3nicholas03/GTSR-POCAN/ADC.kicad_sch

## KiCad design ADC.kicad_sch (2026-01-30)

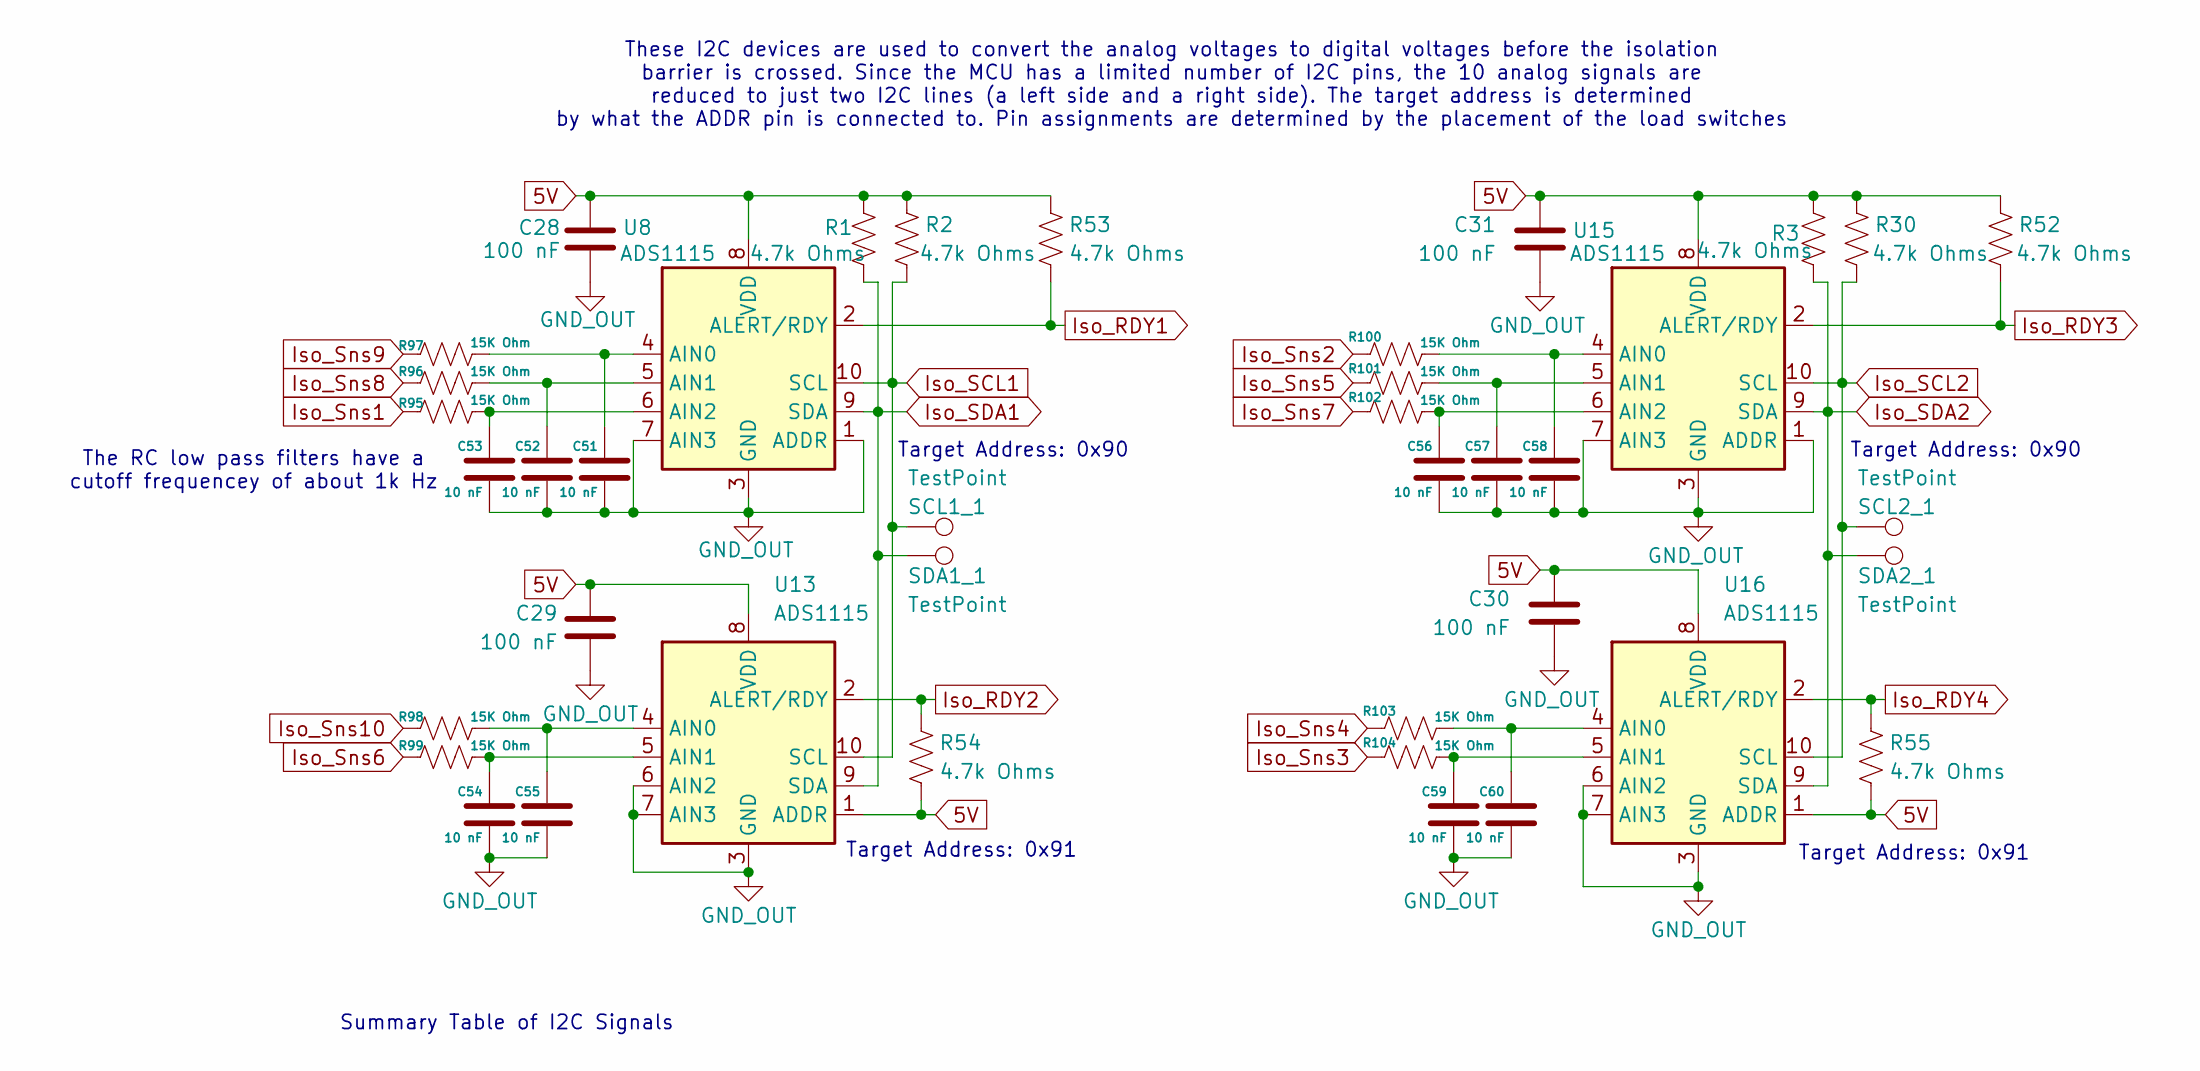
[picture p1: schematic ADC.kicad_sch]

Parts:
C28, C29, C30, C31: 100 nF; C_0603_1608Metric
C51, C52, C53, C54, C55, C56, C57, C58, C59, C60: 10 nF; C_0603_1608Metric
R1, R2, R3, R30, R52, R53, R54, R55: 4.7k Ohms; R_0603_1608Metric
R95, R96, R97, R98, R99, R100, R101, R102, R103, R104: 15K Ohm; R_0603_1608Metric
SCL1_1, SCL2_1: TestPoint; TestPoint_Keystone_5000-5004_Miniature
SDA1_1, SDA2_1: TestPoint; TestPoint_Keystone_5000-5004_Miniature
U8, U13, U15, U16: ADS1115; VSSOP-10_3x3mm_P0.5mm

Connections:
5V: C28.1, C29.1, C30.1, C31.1, R1.1, R2.1, R3.1, R30.1, R52.1, R53.1, R54.2, R55.2, U8.8 (VDD), U13.1 (ADDR), U13.8 (VDD), U15.8 (VDD), U16.1 (ADDR), U16.8 (VDD)
GND_OUT: C28.2, C29.2, C30.2, C31.2, C51.2, C52.2, C53.2, C54.2, C55.2, C56.2, C57.2, C58.2, C59.2, C60.2, U8.1 (ADDR), U8.3 (GND), U8.7 (AIN3), U13.3 (GND), U13.6 (AIN2), U13.7 (AIN3), U15.1 (ADDR), U15.3 (GND), U15.7 (AIN3), U16.3 (GND), U16.6 (AIN2), U16.7 (AIN3)
Iso_RDY1: R53.2, U8.2 (ALERT/RDY)
Iso_RDY2: R54.1, U13.2 (ALERT/RDY)
Iso_RDY3: R52.2, U15.2 (ALERT/RDY)
Iso_RDY4: R55.1, U16.2 (ALERT/RDY)
Iso_SCL1: R2.2, SCL1_1.1, U8.10 (SCL), U13.10 (SCL)
Iso_SCL2: R30.2, SCL2_1.1, U15.10 (SCL), U16.10 (SCL)
Iso_SDA1: R1.2, SDA1_1.1, U8.9 (SDA), U13.9 (SDA)
Iso_SDA2: R3.2, SDA2_1.1, U15.9 (SDA), U16.9 (SDA)
Iso_Sns1: R95.2
Iso_Sns2: R100.2
Iso_Sns3: R104.2
Iso_Sns4: R103.2
Iso_Sns5: R101.2
Iso_Sns6: R99.2
Iso_Sns7: R102.2
Iso_Sns8: R96.2
Iso_Sns9: R97.2
Iso_Sns10: R98.2
unnamed: C51.1, R97.1, U8.4 (AIN0)
unnamed: C52.1, R96.1, U8.5 (AIN1)
unnamed: C53.1, R95.1, U8.6 (AIN2)
unnamed: C54.1, R99.1, U13.5 (AIN1)
unnamed: C55.1, R98.1, U13.4 (AIN0)
unnamed: C56.1, R102.1, U15.6 (AIN2)
unnamed: C57.1, R101.1, U15.5 (AIN1)
unnamed: C58.1, R100.1, U15.4 (AIN0)
unnamed: C59.1, R104.1, U16.5 (AIN1)
unnamed: C60.1, R103.1, U16.4 (AIN0)

Notes on the sheet:
Target Address: 0x91
These I2C devices are used to convert the analog voltages to digital voltages before the isolation barrier is crossed. Since the MCU has a limited number of I2C pins, the 10 analog signals are reduced to just two I2C lines (a left side and a right side). The target address is determined by what the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
Target Address: 0x90
Summary Table of I2C Signals
The RC low pass filters have a cutoff frequencey of about 1k Hz
