3nicholas03/GTSR-POCAN/CAN.kicad_sch

## KiCad design CAN.kicad_sch (2026-01-30)

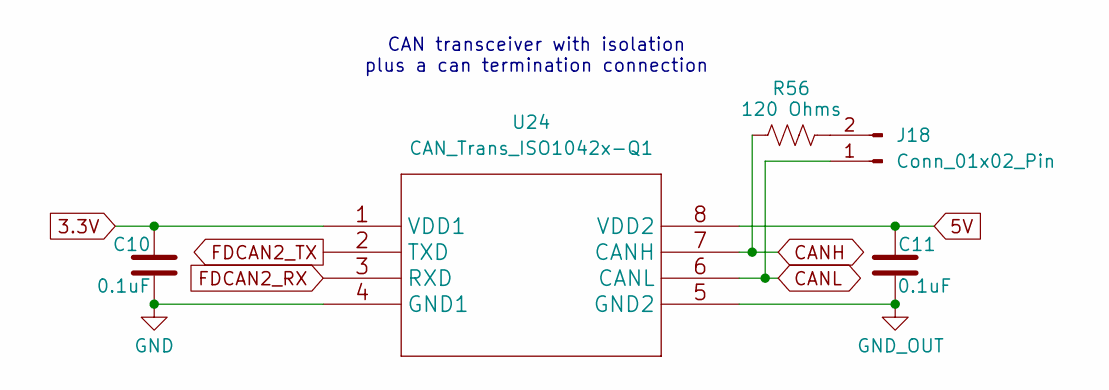
[picture p2: schematic CAN.kicad_sch]

Parts:
C10, C11: 0.1uF; C_0603_1608Metric
J18: Conn_01x02_Pin; PinHeader_1x02_P2.54mm_Vertical
R56: 120 Ohms; R_0603_1608Metric; Part Name R_0603_120
U24: CAN_Trans_ISO1042x-Q1; SOIC-8_7.5x5.85mm_P1.27mm

Connections:
3.3V: C10.2, U24.1 (VDD1)
5V: C11.2, U24.8 (VDD2)
CANH: R56.2, U24.7 (CANH)
CANL: J18.1, U24.6 (CANL)
FDCAN2_RX: U24.3 (RXD)
FDCAN2_TX: U24.2 (TXD)
GND: C10.1, U24.4 (GND1)
GND_OUT: C11.1, U24.5 (GND2)
unnamed: J18.2, R56.1

Notes on the sheet:
CAN transceiver with isolation plus a can termination connection
