3nicholas03/GTSR-POCAN/Digital_Isolation.kicad_sch

## KiCad design Digital_Isolation.kicad_sch (2026-01-30)

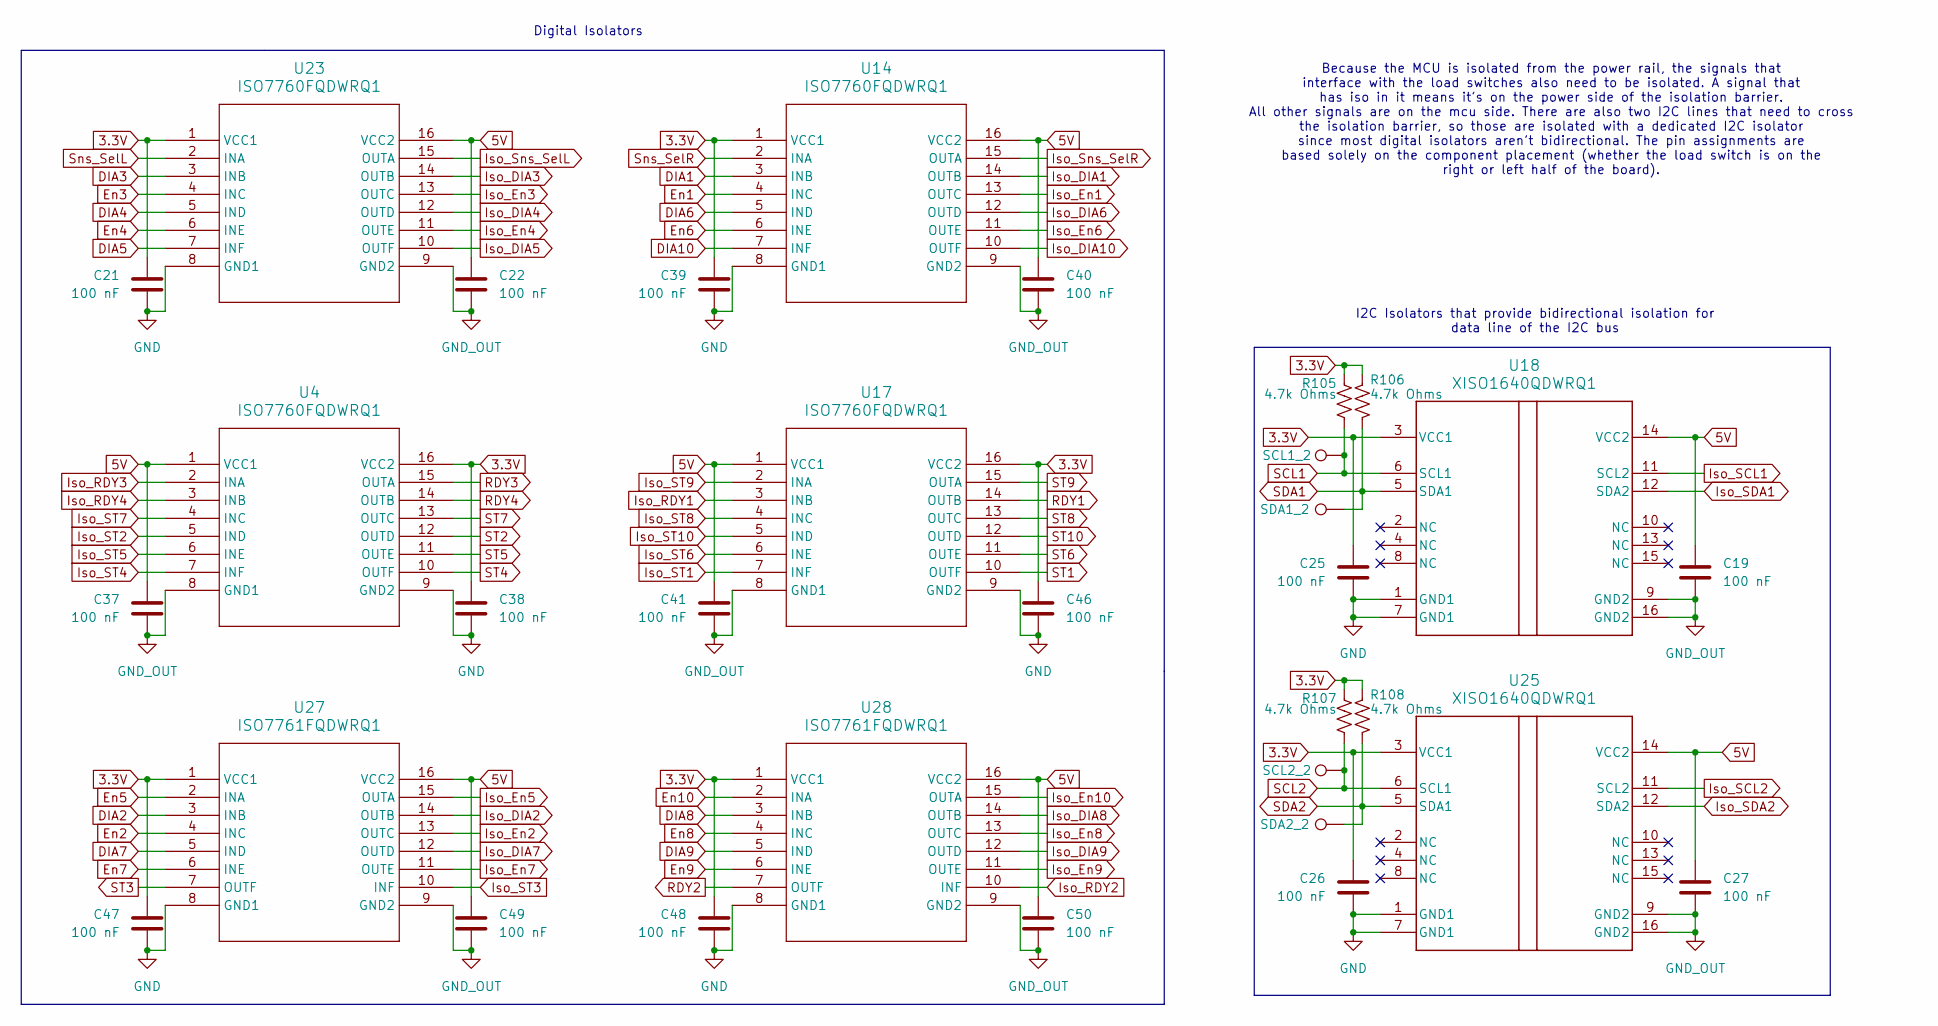
[picture p3: schematic Digital_Isolation.kicad_sch]

Parts:
C19, C21, C22, C25, C26, C27, C37, C38, C39, C40, C41, C46, C47, C48, C49, C50: 100 nF; C_0603_1608Metric
R105, R106, R107, R108: 4.7k Ohms; R_0603_1608Metric
SCL1_2, SCL2_2: TestPoint; TestPoint_Keystone_5000-5004_Miniature
SDA1_2, SDA2_2: TestPoint; TestPoint_Keystone_5000-5004_Miniature
U4, U14, U17, U23: ISO7760FQDWRQ1; SOIC-16W_7.5x10.3mm_P1.27mm
U18, U25: XISO1640QDWRQ1; SOIC-16W_7.5x10.3mm_P1.27mm
U27, U28: ISO7761FQDWRQ1; SOIC-16W_7.5x10.3mm_P1.27mm

Connections:
3.3V: C21.1, C25.1, C26.1, C38.1, C39.1, C46.1, C47.1, C48.1, R105.1, R106.1, R107.1, R108.1, U4.16 (VCC2), U14.1 (VCC1), U17.16 (VCC2), U18.3 (VCC1), U23.1 (VCC1), U25.3 (VCC1), U27.1 (VCC1), U28.1 (VCC1)
5V: C19.1, C22.1, C27.1, C37.1, C40.1, C41.1, C49.1, C50.1, U4.1 (VCC1), U14.16 (VCC2), U17.1 (VCC1), U18.14 (VCC2), U23.16 (VCC2), U25.14 (VCC2), U27.16 (VCC2), U28.16 (VCC2)
DIA1: U14.3 (INB)
DIA2: U27.3 (INB)
DIA3: U23.3 (INB)
DIA4: U23.5 (IND)
DIA5: U23.7 (INF)
DIA6: U14.5 (IND)
DIA7: U27.5 (IND)
DIA8: U28.3 (INB)
DIA9: U28.5 (IND)
DIA10: U14.7 (INF)
En1: U14.4 (INC)
En2: U27.4 (INC)
En3: U23.4 (INC)
En4: U23.6 (INE)
En5: U27.2 (INA)
En6: U14.6 (INE)
En7: U27.6 (INE)
En8: U28.4 (INC)
En9: U28.6 (INE)
En10: U28.2 (INA)
GND: C21.2, C25.2, C26.2, C38.2, C39.2, C46.2, C47.2, C48.2, U4.9 (GND2), U14.8 (GND1), U17.9 (GND2), U18.1 (GND1), U18.7 (GND1), U23.8 (GND1), U25.1 (GND1), U25.7 (GND1), U27.8 (GND1), U28.8 (GND1)
GND_OUT: C19.2, C22.2, C27.2, C37.2, C40.2, C41.2, C49.2, C50.2, U4.8 (GND1), U14.9 (GND2), U17.8 (GND1), U18.9 (GND2), U18.16 (GND2), U23.9 (GND2), U25.9 (GND2), U25.16 (GND2), U27.9 (GND2), U28.9 (GND2)
Iso_DIA1: U14.14 (OUTB)
Iso_DIA2: U27.14 (OUTB)
Iso_DIA3: U23.14 (OUTB)
Iso_DIA4: U23.12 (OUTD)
Iso_DIA5: U23.10 (OUTF)
Iso_DIA6: U14.12 (OUTD)
Iso_DIA7: U27.12 (OUTD)
Iso_DIA8: U28.14 (OUTB)
Iso_DIA9: U28.12 (OUTD)
Iso_DIA10: U14.10 (OUTF)
Iso_En1: U14.13 (OUTC)
Iso_En2: U27.13 (OUTC)
Iso_En3: U23.13 (OUTC)
Iso_En4: U23.11 (OUTE)
Iso_En5: U27.15 (OUTA)
Iso_En6: U14.11 (OUTE)
Iso_En7: U27.11 (OUTE)
Iso_En8: U28.13 (OUTC)
Iso_En9: U28.11 (OUTE)
Iso_En10: U28.15 (OUTA)
Iso_RDY1: U17.3 (INB)
Iso_RDY2: U28.10 (INF)
Iso_RDY3: U4.2 (INA)
Iso_RDY4: U4.3 (INB)
Iso_SCL1: U18.11 (SCL2)
Iso_SCL2: U25.11 (SCL2)
Iso_SDA1: U18.12 (SDA2)
Iso_SDA2: U25.12 (SDA2)
Iso_ST1: U17.7 (INF)
Iso_ST2: U4.5 (IND)
Iso_ST3: U27.10 (INF)
Iso_ST4: U4.7 (INF)
Iso_ST5: U4.6 (INE)
Iso_ST6: U17.6 (INE)
Iso_ST7: U4.4 (INC)
Iso_ST8: U17.4 (INC)
Iso_ST9: U17.2 (INA)
Iso_ST10: U17.5 (IND)
Iso_Sns_SelL: U23.15 (OUTA)
Iso_Sns_SelR: U14.15 (OUTA)
RDY1: U17.14 (OUTB)
RDY2: U28.7 (OUTF)
RDY3: U4.15 (OUTA)
RDY4: U4.14 (OUTB)
SCL1: R105.2, SCL1_2.1, U18.6 (SCL1)
SCL2: R107.2, SCL2_2.1, U25.6 (SCL1)
SDA1: R106.2, SDA1_2.1, U18.5 (SDA1)
SDA2: R108.2, SDA2_2.1, U25.5 (SDA1)
ST1: U17.10 (OUTF)
ST2: U4.12 (OUTD)
ST3: U27.7 (OUTF)
ST4: U4.10 (OUTF)
ST5: U4.11 (OUTE)
ST6: U17.11 (OUTE)
ST7: U4.13 (OUTC)
ST8: U17.13 (OUTC)
ST9: U17.15 (OUTA)
ST10: U17.12 (OUTD)
Sns_SelL: U23.2 (INA)
Sns_SelR: U14.2 (INA)

Notes on the sheet:
I2C Isolators that provide bidirectional isolation for data line of the I2C bus
Digital Isolators
Because the MCU is isolated from the power rail, the signals that interface with the load switches also need to be isolated. A signal that has iso in it means it's on the power side of the isolation barrier. All other signals are on the mcu side. There are also two I2C lines that need to cross the 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
