3nicholas03/GTSR-POCAN/Inputs.kicad_sch

## KiCad design Inputs.kicad_sch (2026-01-30)

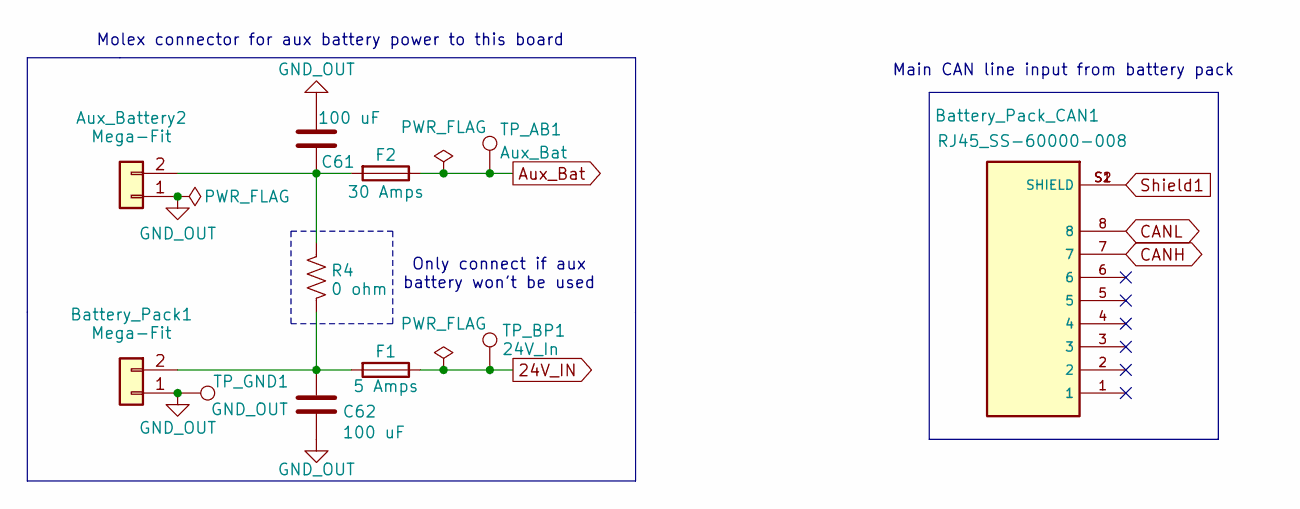
[picture p4: schematic Inputs.kicad_sch]

Parts:
Aux_Battery2: Mega-Fit; Molex_Mega-Fit_76829-0002_2x01_P5.70mm_Vertical; PARTREV A
Battery_Pack1: Mega-Fit; Molex_Mega-Fit_76829-0002_2x01_P5.70mm_Vertical; PARTREV A
Battery_Pack_CAN1: RJ45_SS-60000-008; ASSMANN_A-2004-2-4-LPS-N-R
C61, C62: 100 uF; CP_Elec_10x10
F1: 5 Amps; FUSE_3581
F2: 30 Amps; FUSE_3581
R4: 0 ohm; R_Axial_DIN0207_L6.3mm_D2.5mm_P7.62mm_Horizontal
TP_AB1: Aux_Bat; TestPoint_Pad_D1.5mm
TP_BP1: 24V_In; TestPoint_Pad_D1.5mm
TP_GND1: GND_OUT; TestPoint_Pad_D1.5mm

Connections:
24V_IN: F1.1, TP_BP1.1
Aux_Bat: F2.1, TP_AB1.1
CANH: Battery_Pack_CAN1.7
CANL: Battery_Pack_CAN1.8
GND_OUT: Aux_Battery2.1, Battery_Pack1.1, C61.2, C62.2, TP_GND1.1
unnamed: Aux_Battery2.2, C61.1, F2.2, R4.2
unnamed: Battery_Pack1.2, C62.1, F1.2, R4.1
Shield1: Battery_Pack_CAN1.S1 (SHIELD), Battery_Pack_CAN1.S2 (SHIELD)

Notes on the sheet:
Only connect if aux battery won't be used
Molex connector for aux battery power to this board
Main CAN line input from battery pack
