3nicholas03/GTSR-POCAN/Load_Switches.kicad_sch

## KiCad design Load_Switches.kicad_sch (2026-01-30)

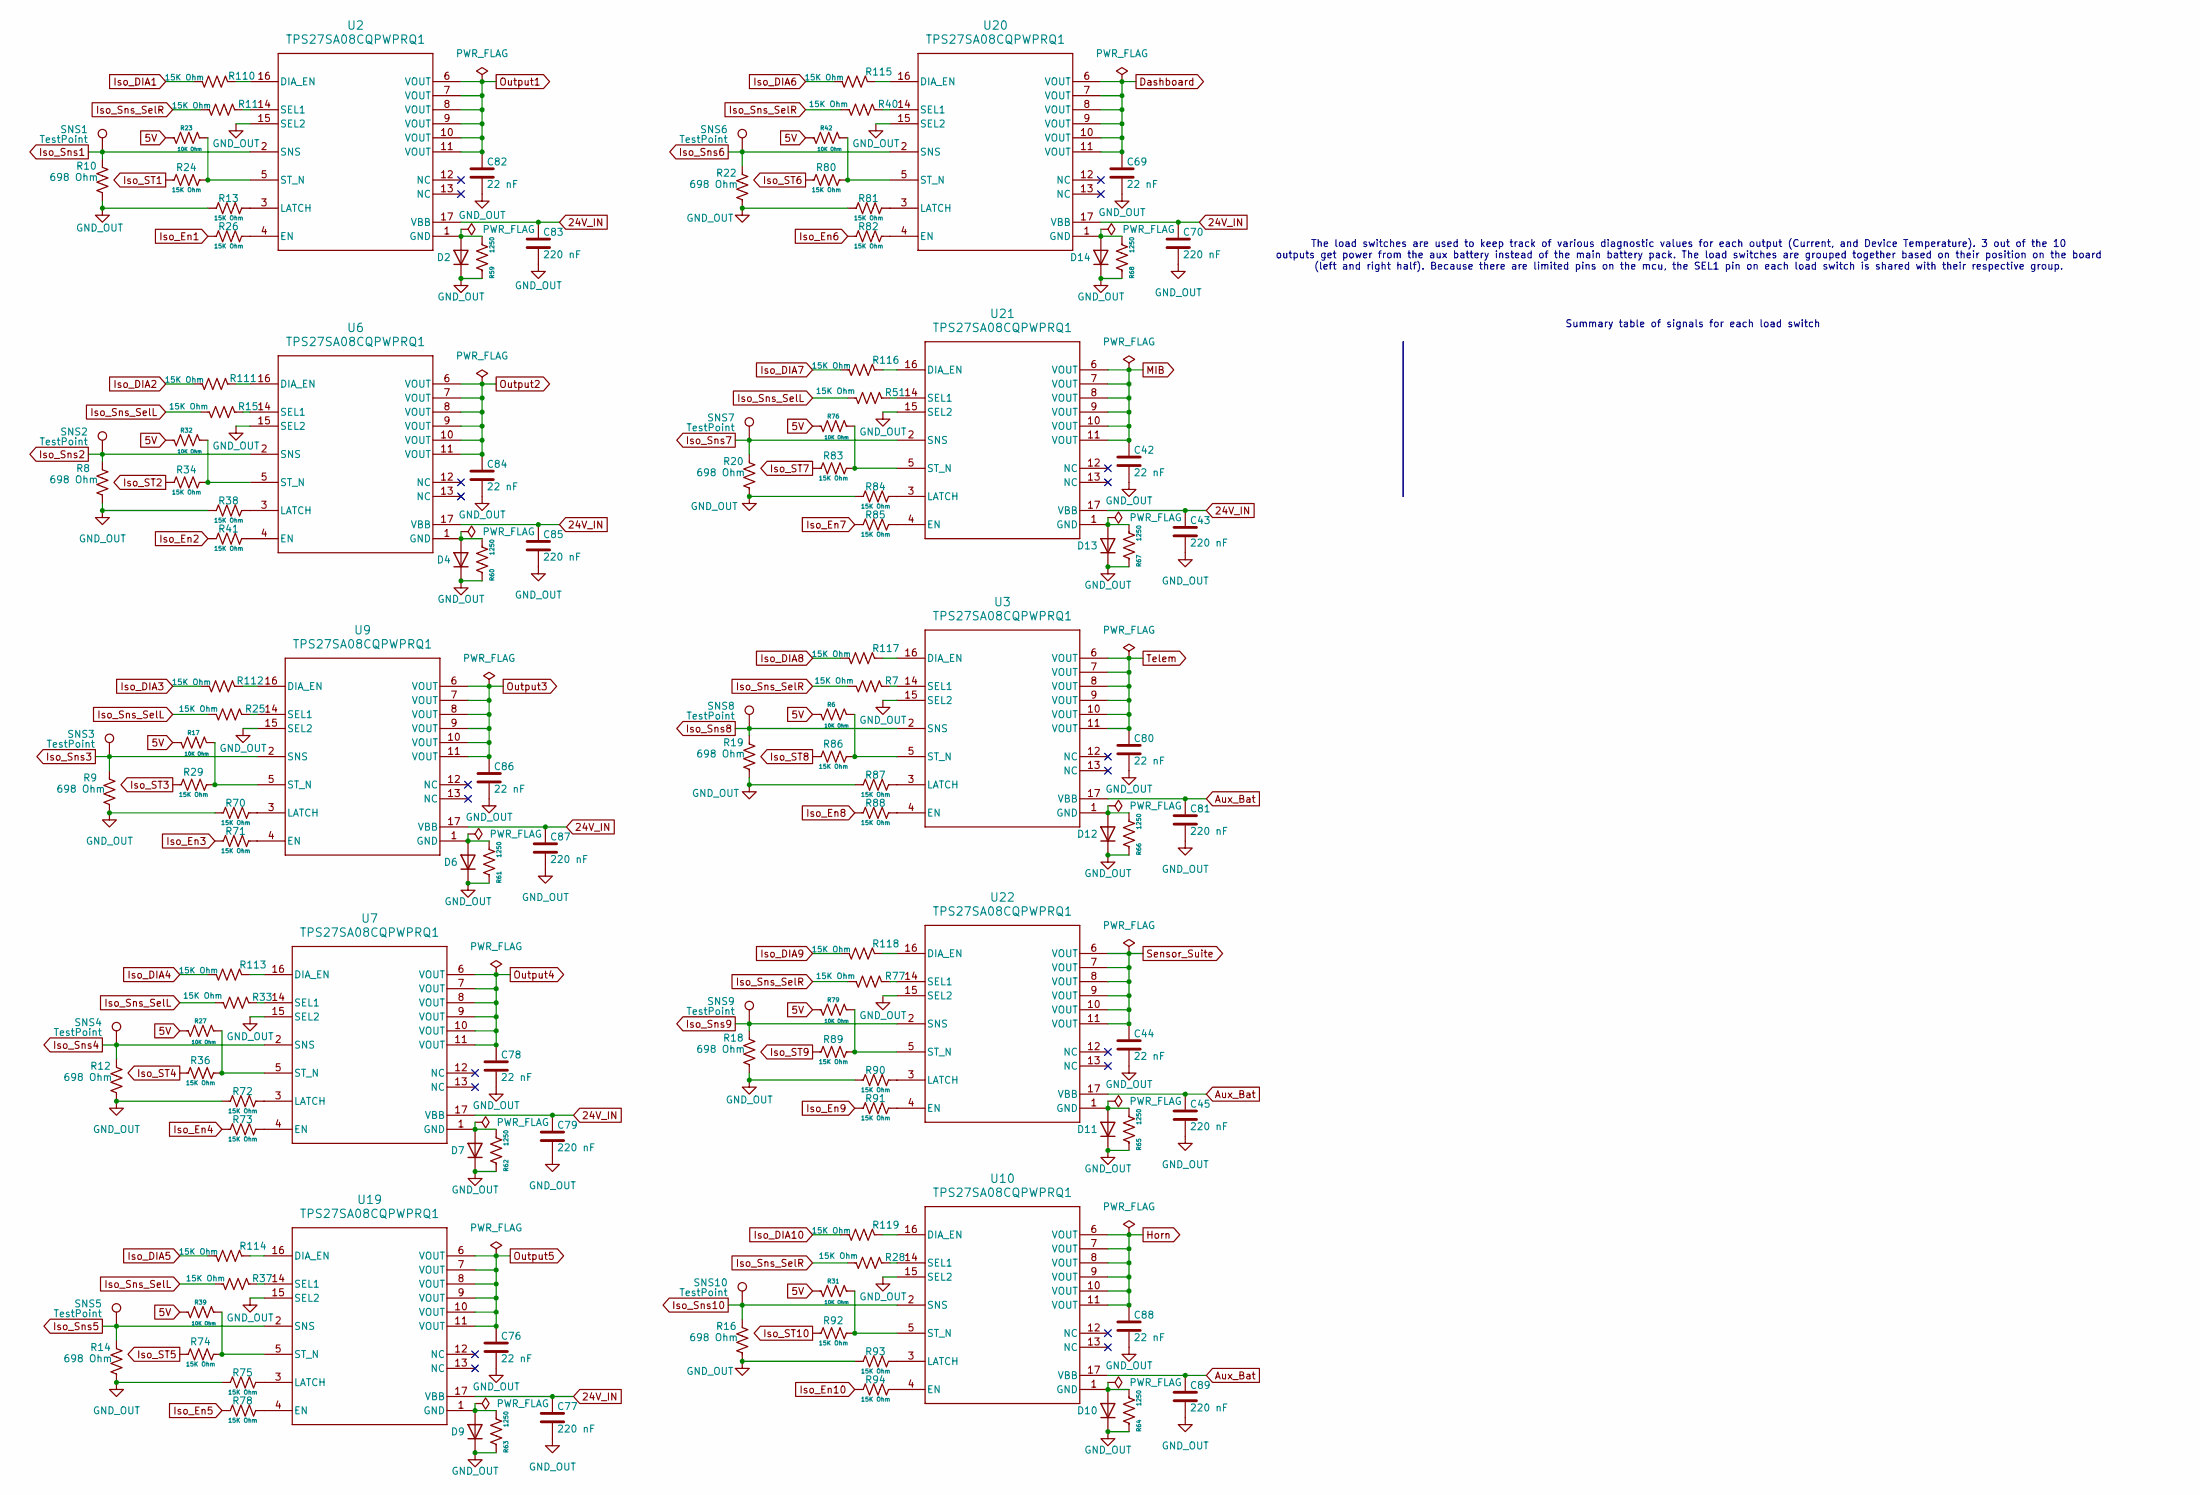
[picture p5: schematic Load_Switches.kicad_sch]

Parts:
C42, C44, C69, C76, C78, C80, C82, C84, C86, C88: 22 nF; C_0603_1608Metric
C43, C45, C70, C77, C79, C81, C83, C85, C87, C89: 220 nF; C_0603_1608Metric
D2, D4, D6, D7, D9, D10, D11, D12, D13, D14: BAS21; SOT-23
R6, R17, R23, R27, R31, R32, R39, R42, R76, R79: 10K Ohm; R_0603_1608Metric
R7, R11, R13, R15, R24, R25, R26, R28, R29, R33, R34, R36, R37, R38, R40, R41, R51, R70, R71, R72, R73, R74, R75, R77, R78, R80, R81, R82, R83, R84, R85, R86, R87, R88, R89, R90, R91, R92, R93, R94, R110, R111, R112, R113, R114, R115, R116, R117, R118, R119: 15K Ohm; R_0603_1608Metric
R8, R9, R10, R12, R14, R16, R18, R19, R20, R22: 698 Ohm; R_0603_1608Metric
R59, R60, R61, R62, R63, R64, R65, R66, R67, R68: 1250; R_0603_1608Metric
SNS1, SNS2, SNS3, SNS4, SNS5, SNS6, SNS7, SNS8, SNS9, SNS10: TestPoint; TestPoint_Keystone_5000-5004_Miniature
U2, U3, U6, U7, U9, U10, U19, U20, U21, U22: TPS27SA08CQPWPRQ1; HTSSOP-16-1EP_4.4x5mm_P0.65mm_EP3.4x5mm

Connections:
5V: R6.2, R17.2, R23.2, R27.2, R31.2, R32.2, R39.2, R42.2, R76.2, R79.2
24V_IN: C43.1, C70.1, C77.1, C79.1, C83.1, C85.1, C87.1, U2.17 (VBB), U6.17 (VBB), U7.17 (VBB), U9.17 (VBB), U19.17 (VBB), U20.17 (VBB), U21.17 (VBB)
Aux_Bat: C45.1, C81.1, C89.1, U3.17 (VBB), U10.17 (VBB), U22.17 (VBB)
Dashboard: C69.1, U20.6 (VOUT), U20.7 (VOUT), U20.8 (VOUT), U20.9 (VOUT), U20.10 (VOUT), U20.11 (VOUT)
GND_OUT: C42.2, C43.2, C44.2, C45.2, C69.2, C70.2, C76.2, C77.2, C78.2, C79.2, C80.2, C81.2, C82.2, C83.2, C84.2, C85.2, C86.2, C87.2, C88.2, C89.2, D2.3 (K), D4.3 (K), D6.3 (K), D7.3 (K), D9.3 (K), D10.3 (K), D11.3 (K), D12.3 (K), D13.3 (K), D14.3 (K), R8.2, R9.2, R10.2, R12.2, R13.2, R14.2, R16.2, R18.2, R19.2, R20.2, R22.2, R38.2, R59.1, R60.1, R61.1, R62.1, R63.1, R64.1, R65.1, R66.1, R67.1, R68.1, R70.2, R72.2, R75.2, R81.2, R84.2, R87.2, R90.2, R93.2, U2.15 (SEL2), U3.15 (SEL2), U6.15 (SEL2), U7.15 (SEL2), U9.15 (SEL2), U10.15 (SEL2), U19.15 (SEL2), U20.15 (SEL2), U21.15 (SEL2), U22.15 (SEL2)
Horn: C88.1, U10.6 (VOUT), U10.7 (VOUT), U10.8 (VOUT), U10.9 (VOUT), U10.10 (VOUT), U10.11 (VOUT)
Iso_DIA1: R110.2
Iso_DIA2: R111.2
Iso_DIA3: R112.2
Iso_DIA4: R113.2
Iso_DIA5: R114.2
Iso_DIA6: R115.2
Iso_DIA7: R116.2
Iso_DIA8: R117.2
Iso_DIA9: R118.2
Iso_DIA10: R119.2
Iso_En1: R26.2
Iso_En2: R41.2
Iso_En3: R71.2
Iso_En4: R73.2
Iso_En5: R78.2
Iso_En6: R82.2
Iso_En7: R85.2
Iso_En8: R88.2
Iso_En9: R91.2
Iso_En10: R94.2
Iso_ST1: R24.2
Iso_ST2: R34.2
Iso_ST3: R29.2
Iso_ST4: R36.2
Iso_ST5: R74.2
Iso_ST6: R80.2
Iso_ST7: R83.2
Iso_ST8: R86.2
Iso_ST9: R89.2
Iso_ST10: R92.2
Iso_Sns1: R10.1, SNS1.1, U2.2 (SNS)
Iso_Sns2: R8.1, SNS2.1, U6.2 (SNS)
Iso_Sns3: R9.1, SNS3.1, U9.2 (SNS)
Iso_Sns4: R12.1, SNS4.1, U7.2 (SNS)
Iso_Sns5: R14.1, SNS5.1, U19.2 (SNS)
Iso_Sns6: R22.1, SNS6.1, U20.2 (SNS)
Iso_Sns7: R20.1, SNS7.1, U21.2 (SNS)
Iso_Sns8: R19.1, SNS8.1, U3.2 (SNS)
Iso_Sns9: R18.1, SNS9.1, U22.2 (SNS)
Iso_Sns10: R16.1, SNS10.1, U10.2 (SNS)
Iso_Sns_SelL: R15.2, R25.2, R33.2, R37.2, R51.2
Iso_Sns_SelR: R7.2, R11.2, R28.2, R40.2, R77.2
MIB: C42.1, U21.6 (VOUT), U21.7 (VOUT), U21.8 (VOUT), U21.9 (VOUT), U21.10 (VOUT), U21.11 (VOUT)
unnamed: D2.1 (A), R59.2, U2.1 (GND)
unnamed: D4.1 (A), R60.2, U6.1 (GND)
unnamed: D6.1 (A), R61.2, U9.1 (GND)
unnamed: D7.1 (A), R62.2, U7.1 (GND)
unnamed: D9.1 (A), R63.2, U19.1 (GND)
unnamed: D10.1 (A), R64.2, U10.1 (GND)
unnamed: D11.1 (A), R65.2, U22.1 (GND)
unnamed: D12.1 (A), R66.2, U3.1 (GND)
unnamed: D13.1 (A), R67.2, U21.1 (GND)
unnamed: D14.1 (A), R68.2, U20.1 (GND)
unnamed: R6.1, R86.1, U3.5 (ST_N)
unnamed: R7.1, U3.14 (SEL1)
unnamed: R11.1, U2.14 (SEL1)
unnamed: R13.1, U2.3 (LATCH)
unnamed: R15.1, U6.14 (SEL1)
unnamed: R17.1, R29.1, U9.5 (ST_N)
unnamed: R23.1, R24.1, U2.5 (ST_N)
unnamed: R25.1, U9.14 (SEL1)
unnamed: R26.1, U2.4 (EN)
unnamed: R27.1, R36.1, U7.5 (ST_N)
unnamed: R28.1, U10.14 (SEL1)
unnamed: R31.1, R92.1, U10.5 (ST_N)
unnamed: R32.1, R34.1, U6.5 (ST_N)
unnamed: R33.1, U7.14 (SEL1)
unnamed: R37.1, U19.14 (SEL1)
unnamed: R38.1, U6.3 (LATCH)
unnamed: R39.1, R74.1, U19.5 (ST_N)
unnamed: R40.1, U20.14 (SEL1)
unnamed: R41.1, U6.4 (EN)
unnamed: R42.1, R80.1, U20.5 (ST_N)
unnamed: R51.1, U21.14 (SEL1)
unnamed: R70.1, U9.3 (LATCH)
unnamed: R71.1, U9.4 (EN)
unnamed: R72.1, U7.3 (LATCH)
unnamed: R73.1, U7.4 (EN)
unnamed: R75.1, U19.3 (LATCH)
unnamed: R76.1, R83.1, U21.5 (ST_N)
unnamed: R77.1, U22.14 (SEL1)
unnamed: R78.1, U19.4 (EN)
unnamed: R79.1, R89.1, U22.5 (ST_N)
unnamed: R81.1, U20.3 (LATCH)
unnamed: R82.1, U20.4 (EN)
unnamed: R84.1, U21.3 (LATCH)
unnamed: R85.1, U21.4 (EN)
unnamed: R87.1, U3.3 (LATCH)
unnamed: R88.1, U3.4 (EN)
unnamed: R90.1, U22.3 (LATCH)
unnamed: R91.1, U22.4 (EN)
unnamed: R93.1, U10.3 (LATCH)
unnamed: R94.1, U10.4 (EN)
unnamed: R110.1, U2.16 (DIA_EN)
unnamed: R111.1, U6.16 (DIA_EN)
unnamed: R112.1, U9.16 (DIA_EN)
unnamed: R113.1, U7.16 (DIA_EN)
unnamed: R114.1, U19.16 (DIA_EN)
unnamed: R115.1, U20.16 (DIA_EN)
unnamed: R116.1, U21.16 (DIA_EN)
unnamed: R117.1, U3.16 (DIA_EN)
unnamed: R118.1, U22.16 (DIA_EN)
unnamed: R119.1, U10.16 (DIA_EN)
Output1: C82.1, U2.6 (VOUT), U2.7 (VOUT), U2.8 (VOUT), U2.9 (VOUT), U2.10 (VOUT), U2.11 (VOUT)
Output2: C84.1, U6.6 (VOUT), U6.7 (VOUT), U6.8 (VOUT), U6.9 (VOUT), U6.10 (VOUT), U6.11 (VOUT)
Output3: C86.1, U9.6 (VOUT), U9.7 (VOUT), U9.8 (VOUT), U9.9 (VOUT), U9.10 (VOUT), U9.11 (VOUT)
Output4: C78.1, U7.6 (VOUT), U7.7 (VOUT), U7.8 (VOUT), U7.9 (VOUT), U7.10 (VOUT), U7.11 (VOUT)
Output5: C76.1, U19.6 (VOUT), U19.7 (VOUT), U19.8 (VOUT), U19.9 (VOUT), U19.10 (VOUT), U19.11 (VOUT)
Sensor_Suite: C44.1, U22.6 (VOUT), U22.7 (VOUT), U22.8 (VOUT), U22.9 (VOUT), U22.10 (VOUT), U22.11 (VOUT)
Telem: C80.1, U3.6 (VOUT), U3.7 (VOUT), U3.8 (VOUT), U3.9 (VOUT), U3.10 (VOUT), U3.11 (VOUT)

Notes on the sheet:
The load switches are used to keep track of various diagnostic values for each output (Current, and Device Temperature). 3 out of the 10 outputs get power from the aux battery instead of the main battery pack. The load switches are grouped together based on their position on the board (left and rig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
Summary table of signals for each load switch
