3nicholas03/GTSR-POCAN/Outputs.kicad_sch

## KiCad design Outputs.kicad_sch (2026-01-30)

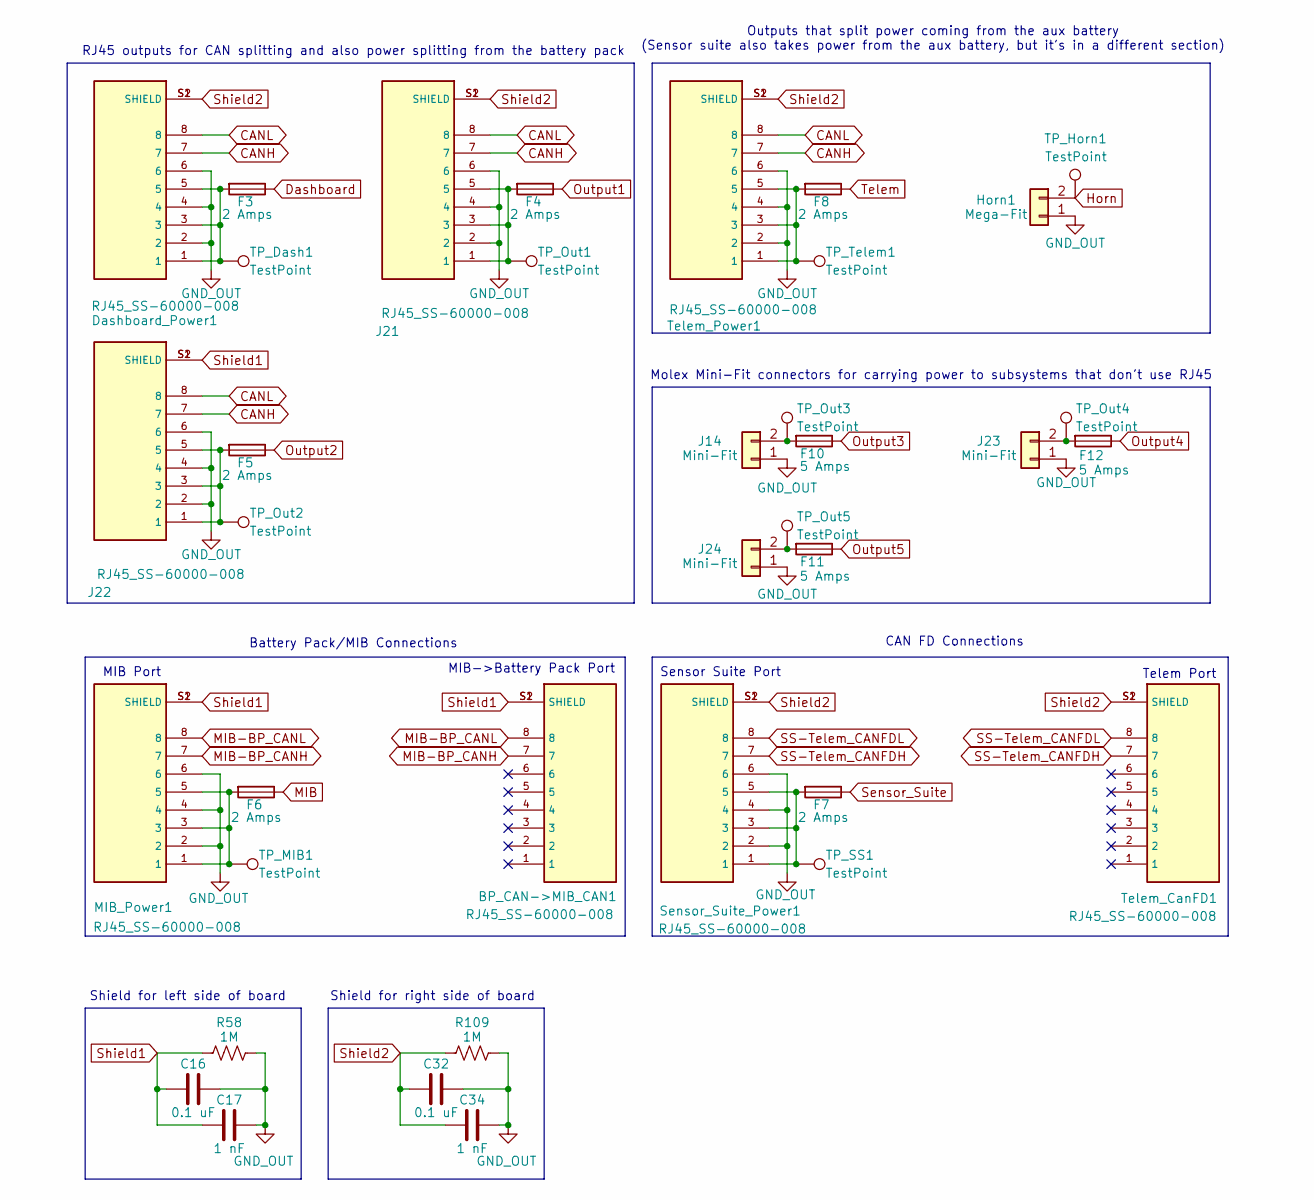
[picture p6: schematic Outputs.kicad_sch]

Parts:
BP_CAN->MIB_CAN1: RJ45_SS-60000-008; ASSMANN_A-2004-2-4-LPS-N-R
C16, C32: 0.1 uF; C_0603_1608Metric
C17, C34: 1 nF; C_0603_1608Metric
Dashboard_Power1: RJ45_SS-60000-008; ASSMANN_A-2004-2-4-LPS-N-R
F3, F4, F5, F6, F7, F8: 2 Amps; Fuse_1206_3216Metric
F10, F11, F12: 5 Amps; Fuse_1206_3216Metric
Horn1: Mega-Fit; Molex_Mega-Fit_76829-0002_2x01_P5.70mm_Vertical; PARTREV A
J14, J23, J24: Mini-Fit; Molex_Mini-Fit_Jr_5566-02A_2x01_P4.20mm_Vertical; PARTREV A
J21, J22: RJ45_SS-60000-008; ASSMANN_A-2004-2-4-LPS-N-R
MIB_Power1: RJ45_SS-60000-008; ASSMANN_A-2004-2-4-LPS-N-R
R58, R109: 1M; R_0603_1608Metric
Sensor_Suite_Power1: RJ45_SS-60000-008; ASSMANN_A-2004-2-4-LPS-N-R
TP_Dash1: TestPoint; TestPoint_Pad_D1.5mm
TP_Horn1: TestPoint; TestPoint_Pad_D1.5mm
TP_MIB1: TestPoint; TestPoint_Pad_D1.5mm
TP_Out1, TP_Out2, TP_Out3, TP_Out4, TP_Out5: TestPoint; TestPoint_Pad_D1.5mm
TP_SS1: TestPoint; TestPoint_Pad_D1.5mm
TP_Telem1: TestPoint; TestPoint_Pad_D1.5mm
Telem_CanFD1: RJ45_SS-60000-008; ASSMANN_A-2004-2-4-LPS-N-R
Telem_Power1: RJ45_SS-60000-008; ASSMANN_A-2004-2-4-LPS-N-R

Connections:
CANH: Dashboard_Power1.7, J21.7, J22.7, Telem_Power1.7
CANL: Dashboard_Power1.8, J21.8, J22.8, Telem_Power1.8
Dashboard: F3.1
GND_OUT: C16.2, C17.2, C32.2, C34.2, Dashboard_Power1.2, Dashboard_Power1.4, Dashboard_Power1.6, Horn1.1, J14.1, J21.2, J21.4, J21.6, J22.2, J22.4, J22.6, J23.1, J24.1, MIB_Power1.2, MIB_Power1.4, MIB_Power1.6, R58.2, R109.2, Sensor_Suite_Power1.2, Sensor_Suite_Power1.4, Sensor_Suite_Power1.6, Telem_Power1.2, Telem_Power1.4, Telem_Power1.6
Horn: Horn1.2, TP_Horn1.1
MIB: F6.1
MIB-BP_CANH: BP_CAN->MIB_CAN1.7, MIB_Power1.7
MIB-BP_CANL: BP_CAN->MIB_CAN1.8, MIB_Power1.8
unnamed: Dashboard_Power1.1, Dashboard_Power1.3, Dashboard_Power1.5, F3.2, TP_Dash1.1
unnamed: F4.2, J21.1, J21.3, J21.5, TP_Out1.1
unnamed: F5.2, J22.1, J22.3, J22.5, TP_Out2.1
unnamed: F6.2, MIB_Power1.1, MIB_Power1.3, MIB_Power1.5, TP_MIB1.1
unnamed: F7.2, Sensor_Suite_Power1.1, Sensor_Suite_Power1.3, Sensor_Suite_Power1.5, TP_SS1.1
unnamed: F8.2, TP_Telem1.1, Telem_Power1.1, Telem_Power1.3, Telem_Power1.5
unnamed: F10.2, J14.2, TP_Out3.1
unnamed: F11.2, J24.2, TP_Out5.1
unnamed: F12.2, J23.2, TP_Out4.1
Output1: F4.1
Output2: F5.1
Output3: F10.1
Output4: F12.1
Output5: F11.1
SS-Telem_CANFDH: Sensor_Suite_Power1.7, Telem_CanFD1.7
SS-Telem_CANFDL: Sensor_Suite_Power1.8, Telem_CanFD1.8
Sensor_Suite: F7.1
Shield1: BP_CAN->MIB_CAN1.S1 (SHIELD), BP_CAN->MIB_CAN1.S2 (SHIELD), C16.1, C17.1, J22.S1 (SHIELD), J22.S2 (SHIELD), MIB_Power1.S1 (SHIELD), MIB_Power1.S2 (SHIELD), R58.1
Shield2: C32.1, C34.1, Dashboard_Power1.S1 (SHIELD), Dashboard_Power1.S2 (SHIELD), J21.S1 (SHIELD), J21.S2 (SHIELD), R109.1, Sensor_Suite_Power1.S1 (SHIELD), Sensor_Suite_Power1.S2 (SHIELD), Telem_CanFD1.S1 (SHIELD), Telem_CanFD1.S2 (SHIELD), Telem_Power1.S1 (SHIELD), Telem_Power1.S2 (SHIELD)
Telem: F8.1

Notes on the sheet:
Shield for right side of board
Sensor Suite Port
Shield for left side of board
Outputs that split power coming from the aux battery (Sensor suite also takes power from the aux battery, but it's in a different section)
CAN FD Connections
MIB Port
MIB->Battery Pack Port
Telem Port
RJ45 outputs for CAN splitting and also power splitting from the battery pack
Molex Mini-Fit connectors for carrying power to subsystems that don't use RJ45
Battery Pack/MIB Connections
