3nicholas03/GTSR-POCAN/Power.kicad_sch

## KiCad design Power.kicad_sch (2026-01-30)

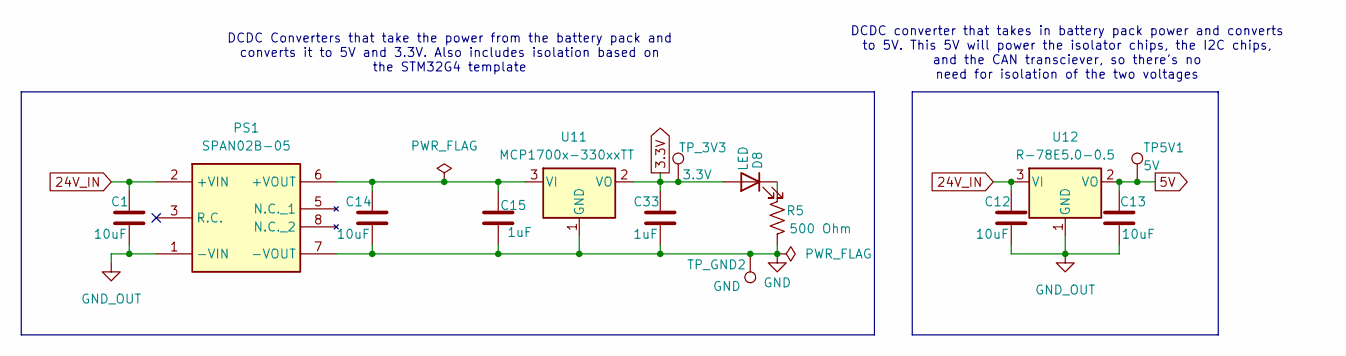
[picture p7: schematic Power.kicad_sch]

Parts:
C1, C12, C13, C14: 10uF; C_0603_1608Metric
C15, C33: 1uF; C_0603_1608Metric
D8: LED; LED_0603_1608Metric
PS1: SPAN02B-05; SPAN02B05; Mouser Part Number 709-SPAN02B-05
R5: 500 Ohm; R_0603_1608Metric
TP5V1: 5V; TestPoint_Pad_D1.5mm
TP_3V3: 3.3V; TestPoint_Pad_D1.5mm
TP_GND2: GND; TestPoint_Pad_D1.5mm
U11: MCP1700x-330xxTT; SOT-23
U12: R-78E5.0-0.5; Converter_DCDC_RECOM_R-78E-0.5_THT

Connections:
3.3V: C33.2, D8.2 (A), TP_3V3.1, U11.2 (VO)
5V: C13.2, TP5V1.1, U12.2 (VO)
24V_IN: C1.2, C12.2, PS1.2 (+VIN), U12.3 (VI)
GND: C14.1, C15.1, C33.1, PS1.7 (-VOUT), R5.2, TP_GND2.1, U11.1 (GND)
GND_OUT: C1.1, C12.1, C13.1, PS1.1 (-VIN), U12.1 (GND)
unnamed: C14.2, C15.2, PS1.6 (+VOUT), U11.3 (VI)
unnamed: D8.1 (K), R5.1

Notes on the sheet:
DCDC Converters that take the power from the battery pack and converts it to 5V and 3.3V. Also includes isolation based on the STM32G4 template
DCDC converter that takes in battery pack power and converts to 5V. This 5V will power the isolator chips, the I2C chips, and the CAN transciever, so there's no need for isolation of the two voltages
