3nicholas03/GTSR-POCAN/STM.kicad_sch

## KiCad design STM.kicad_sch (2026-01-30)

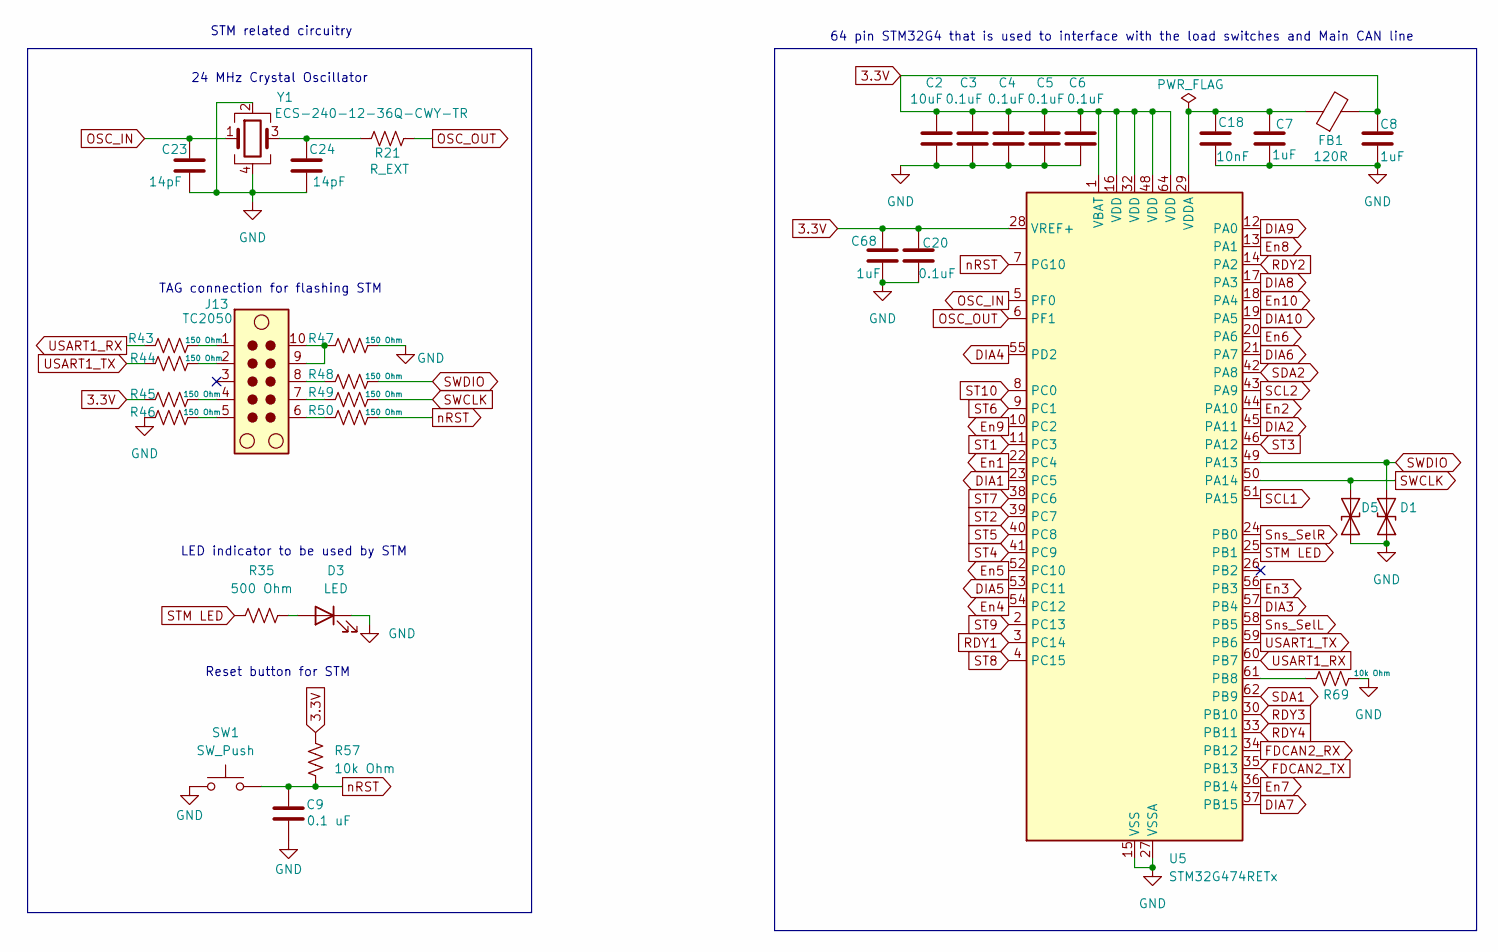
[picture p8: schematic STM.kicad_sch]

Parts:
C2: 10uF; C_0603_1608Metric
C3, C4, C5, C6, C20: 0.1uF; C_0603_1608Metric
C7, C8, C68: 1uF; C_0603_1608Metric
C9: 0.1 uF; C_0603_1608Metric
C18: 10nF; C_0603_1608Metric
C23, C24: 14pF; C_0603_1608Metric
D1, D5: ESD9B3.3ST5G; D_0402_1005Metric
D3: LED; LED_0603_1608Metric
FB1: 120R; R_0603_1608Metric
J13: TC2050; Tag-Connect_TC2050-IDC-FP_2x05_P1.27mm_Vertical
R21: R_EXT; R_0603_1608Metric
R35: 500 Ohm; R_0603_1608Metric
R43, R44, R45, R46, R47, R48, R49, R50: 150 Ohm; R_0603_1608Metric
R57, R69: 10k Ohm; R_0603_1608Metric
SW1: SW_Push; SW_PUSH_6mm
U5: STM32G474RETx; LQFP-64_10x10mm_P0.5mm
Y1: ECS-240-12-36Q-CWY-TR; Crystal_SMD_2520-4Pin_2.5x2.0mm

Connections:
3.3V: C2.2, C3.2, C4.2, C5.2, C6.2, C8.2, C20.2, C68.2, FB1.2, R45.2, R57.2, U5.1 (VBAT), U5.16 (VDD), U5.28 (VREF+), U5.32 (VDD), U5.48 (VDD), U5.64 (VDD)
DIA1: U5.23 (PC5)
DIA2: U5.45 (PA11)
DIA3: U5.57 (PB4)
DIA4: U5.55 (PD2)
DIA5: U5.53 (PC11)
DIA6: U5.21 (PA7)
DIA7: U5.37 (PB15)
DIA8: U5.17 (PA3)
DIA9: U5.12 (PA0)
DIA10: U5.19 (PA5)
En1: U5.22 (PC4)
En2: U5.44 (PA10)
En3: U5.56 (PB3)
En4: U5.54 (PC12)
En5: U5.52 (PC10)
En6: U5.20 (PA6)
En7: U5.36 (PB14)
En8: U5.13 (PA1)
En9: U5.10 (PC2)
En10: U5.18 (PA4)
FDCAN2_RX: U5.34 (PB12)
FDCAN2_TX: U5.35 (PB13)
GND: C2.1, C3.1, C4.1, C5.1, C6.1, C7.1, C8.1, C9.1, C18.1, C20.1, C23.2, C24.2, C68.1, D1.2 (A2), D3.1 (K), D5.2 (A2), R46.2, R47.1, R69.1, SW1.1, U5.15 (VSS), U5.27 (VSSA), U5.31 (VSS), U5.47 (VSS), U5.63 (VSS), Y1.2, Y1.4
unnamed: C7.2, C18.2, FB1.1, U5.29 (VDDA)
unnamed: C24.1, R21.2, Y1.3
unnamed: D3.2 (A), R35.1
unnamed: J13.1, R43.1
unnamed: J13.2, R44.1
unnamed: J13.4, R45.1
unnamed: J13.5, R46.1
unnamed: J13.6, R50.2
unnamed: J13.7, R49.2
unnamed: J13.8, R48.2
unnamed: J13.9, J13.10, R47.2
unnamed: R69.2, U5.61 (PB8)
OSC_IN: C23.1, U5.5 (PF0), Y1.1
OSC_OUT: R21.1, U5.6 (PF1)
RDY1: U5.3 (PC14)
RDY2: U5.14 (PA2)
RDY3: U5.30 (PB10)
RDY4: U5.33 (PB11)
SCL1: U5.51 (PA15)
SCL2: U5.43 (PA9)
SDA1: U5.62 (PB9)
SDA2: U5.42 (PA8)
ST1: U5.11 (PC3)
ST2: U5.39 (PC7)
ST3: U5.46 (PA12)
ST4: U5.41 (PC9)
ST5: U5.40 (PC8)
ST6: U5.9 (PC1)
ST7: U5.38 (PC6)
ST8: U5.4 (PC15)
ST9: U5.2 (PC13)
ST10: U5.8 (PC0)
STM LED: R35.2, U5.25 (PB1)
SWCLK: D5.1 (A1), R49.1, U5.50 (PA14)
SWDIO: D1.1 (A1), R48.1, U5.49 (PA13)
Sns_SelL: U5.58 (PB5)
Sns_SelR: U5.24 (PB0)
USART1_RX: R43.2, U5.60 (PB7)
USART1_TX: R44.2, U5.59 (PB6)
nRST: C9.2, R50.1, R57.1, SW1.2, U5.7 (PG10)

Notes on the sheet:
TAG connection for flashing STM
24 MHz Crystal Oscillator
STM related circuitry
Reset button for STM
64 pin STM32G4 that is used to interface with the load switches and Main CAN line
LED indicator to be used by STM
